marcorispoli/PCB303/LAYOUT/Layout.png

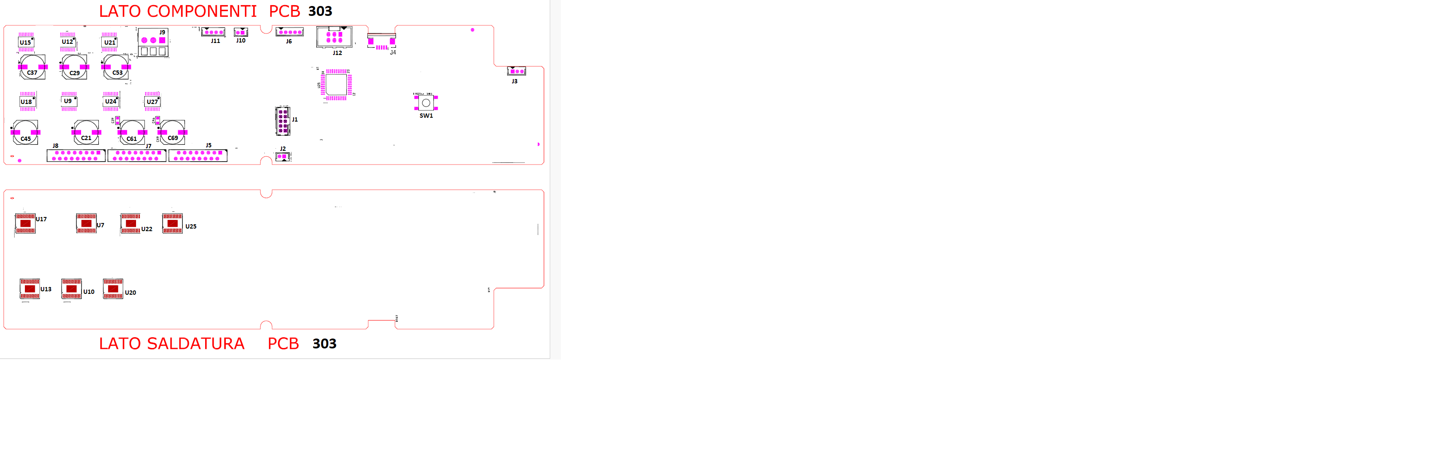
LAYOUT/Layout.png
