marcorispoli/PCB303/(list of files, cad)

Other CAD files:
ESECUTIVI/PF22-303-0.dwg
LAYOUT/22-303-0.dwg
ESECUTIVI/PM22-303-0.dwg
