marcorispoli/PCB303/ORCAD/SE22-303-0.pdf

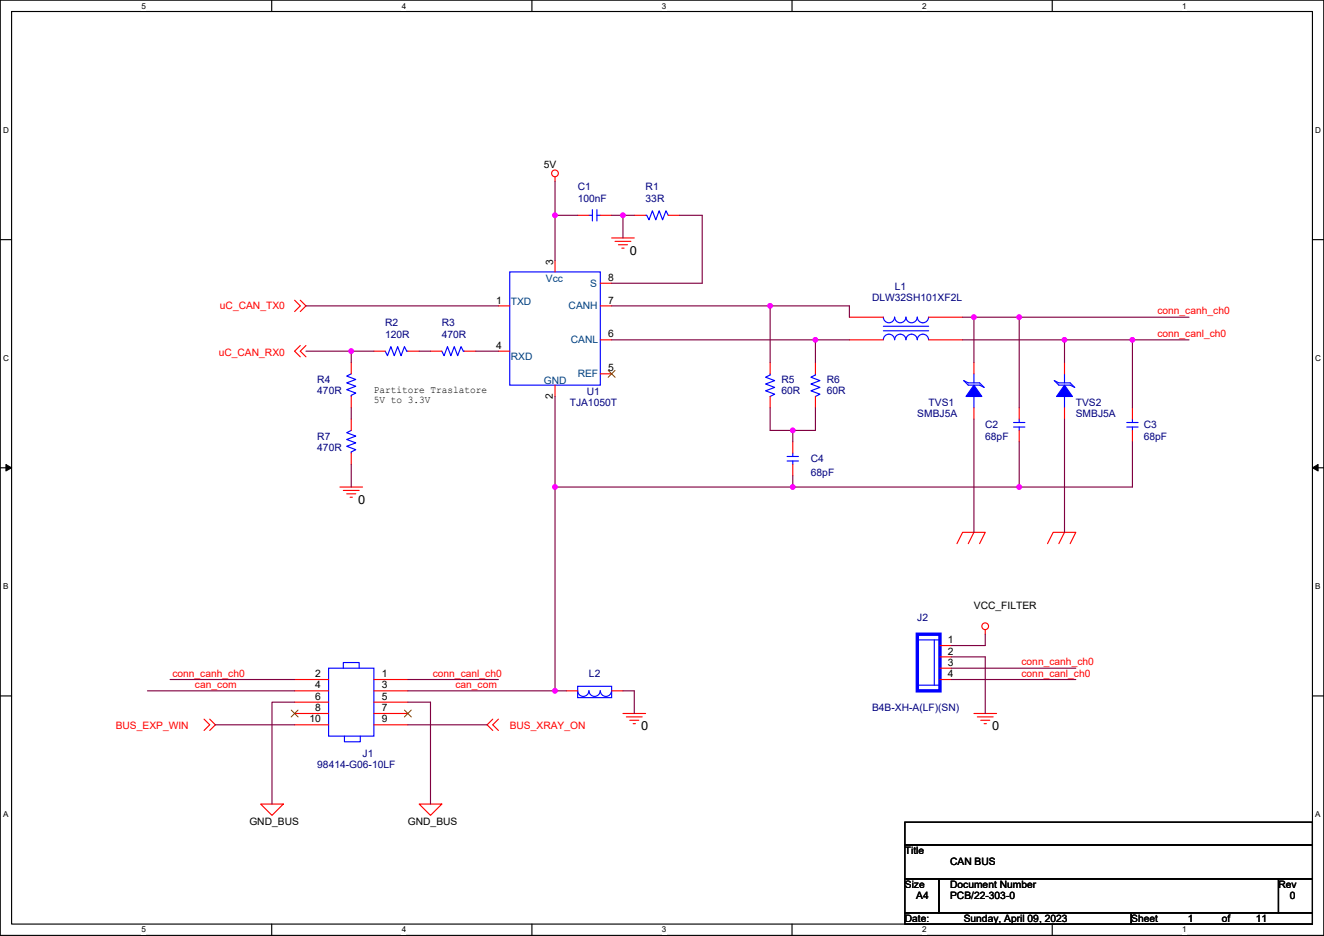
[picture p2: page 1]

Size A4 | Document Number PCB/22-303-0 | Rev 0

Date: Sunday, April 09, 2023 Sunday, April 09, 2023 Sunday, April 09, 2023 | Sheet 1 1 1 of 11 11 11

0

0

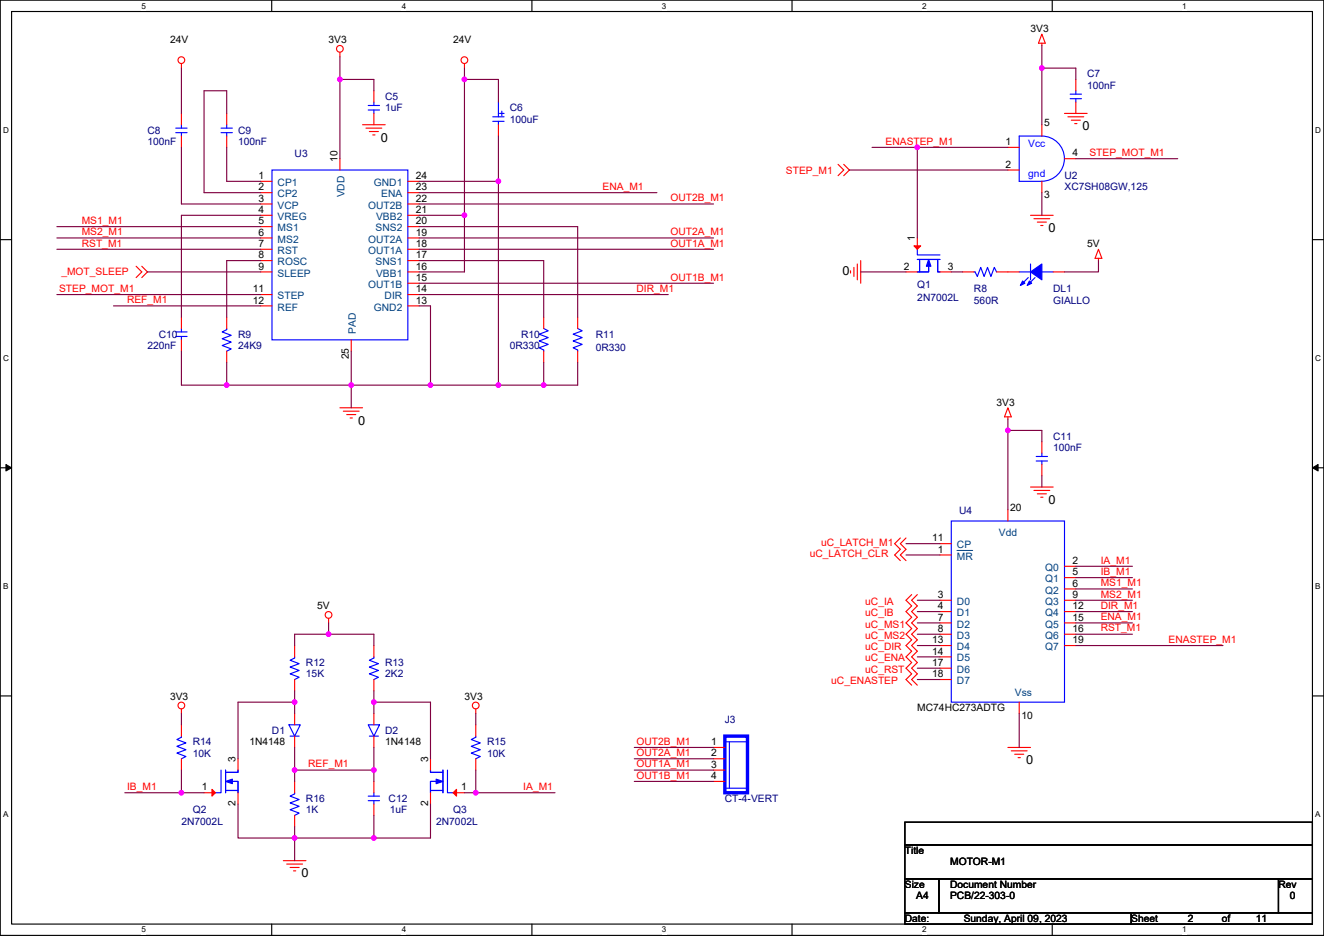
[picture p3: page 2]

0

0

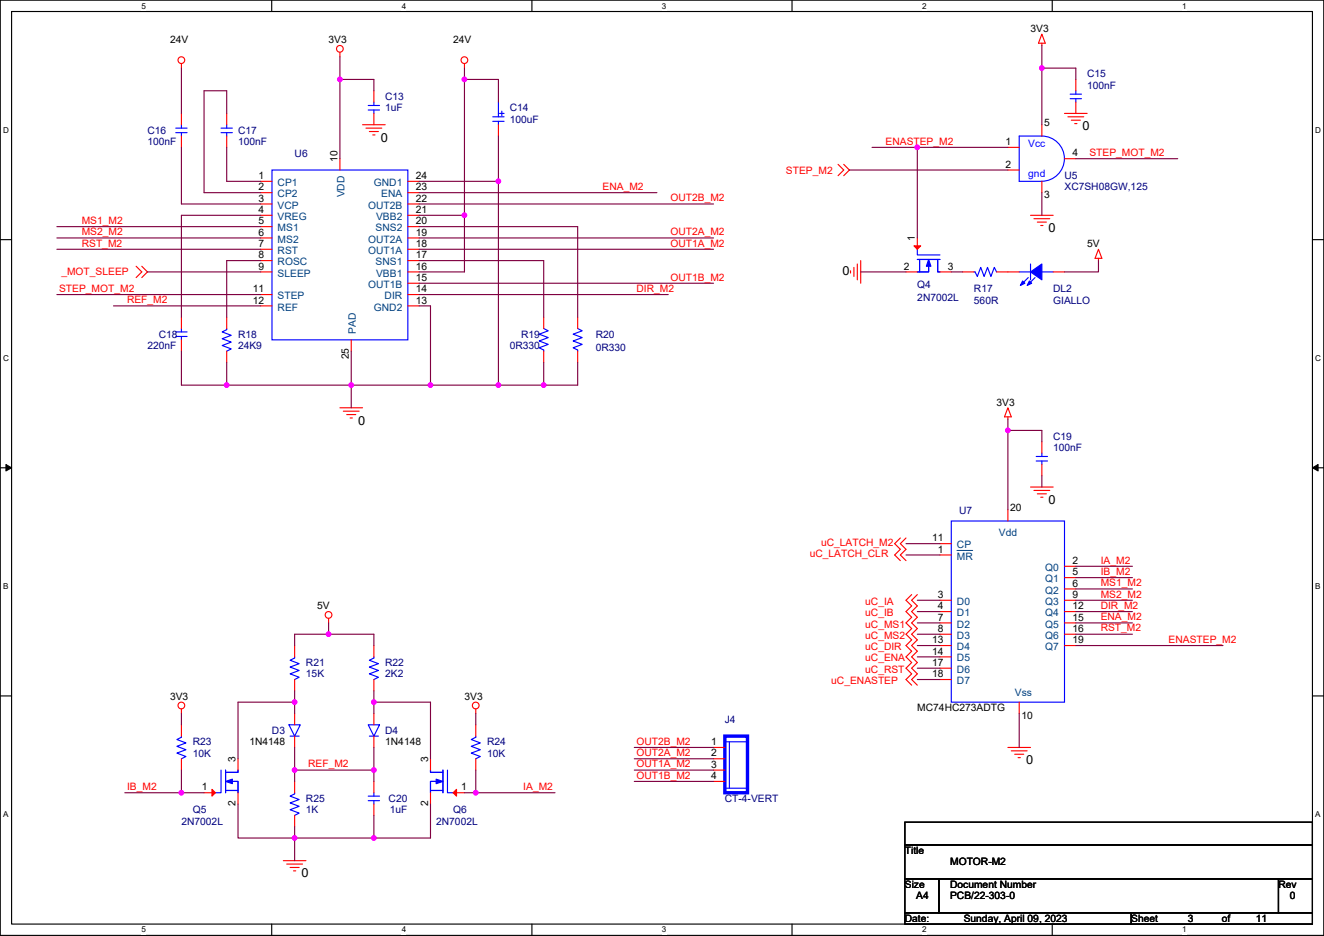
[picture p4: page 3]

0

0

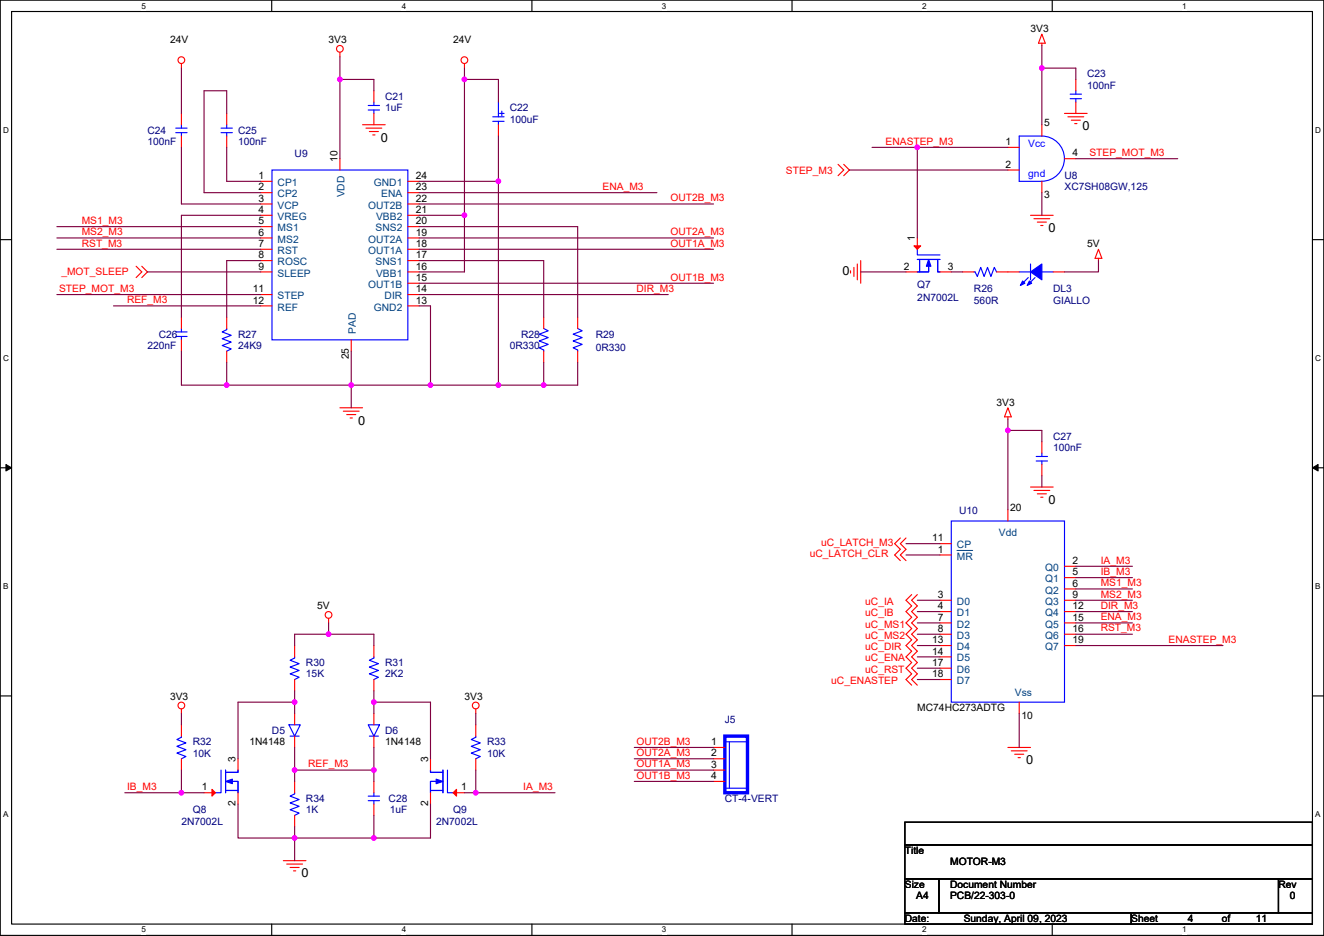
[picture p5: page 4]

0

0

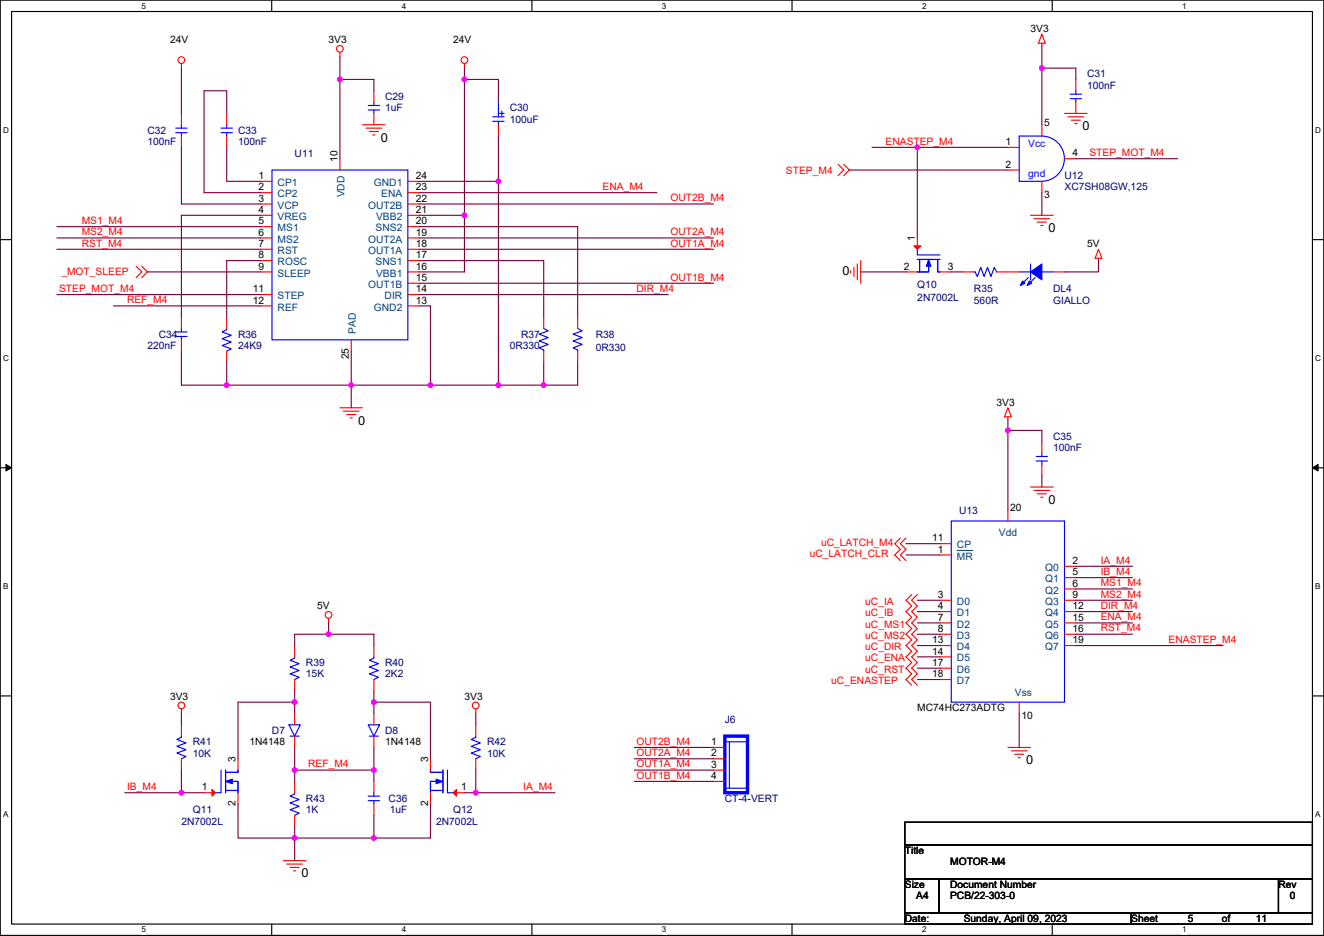
[picture p6: page 5]

0

0

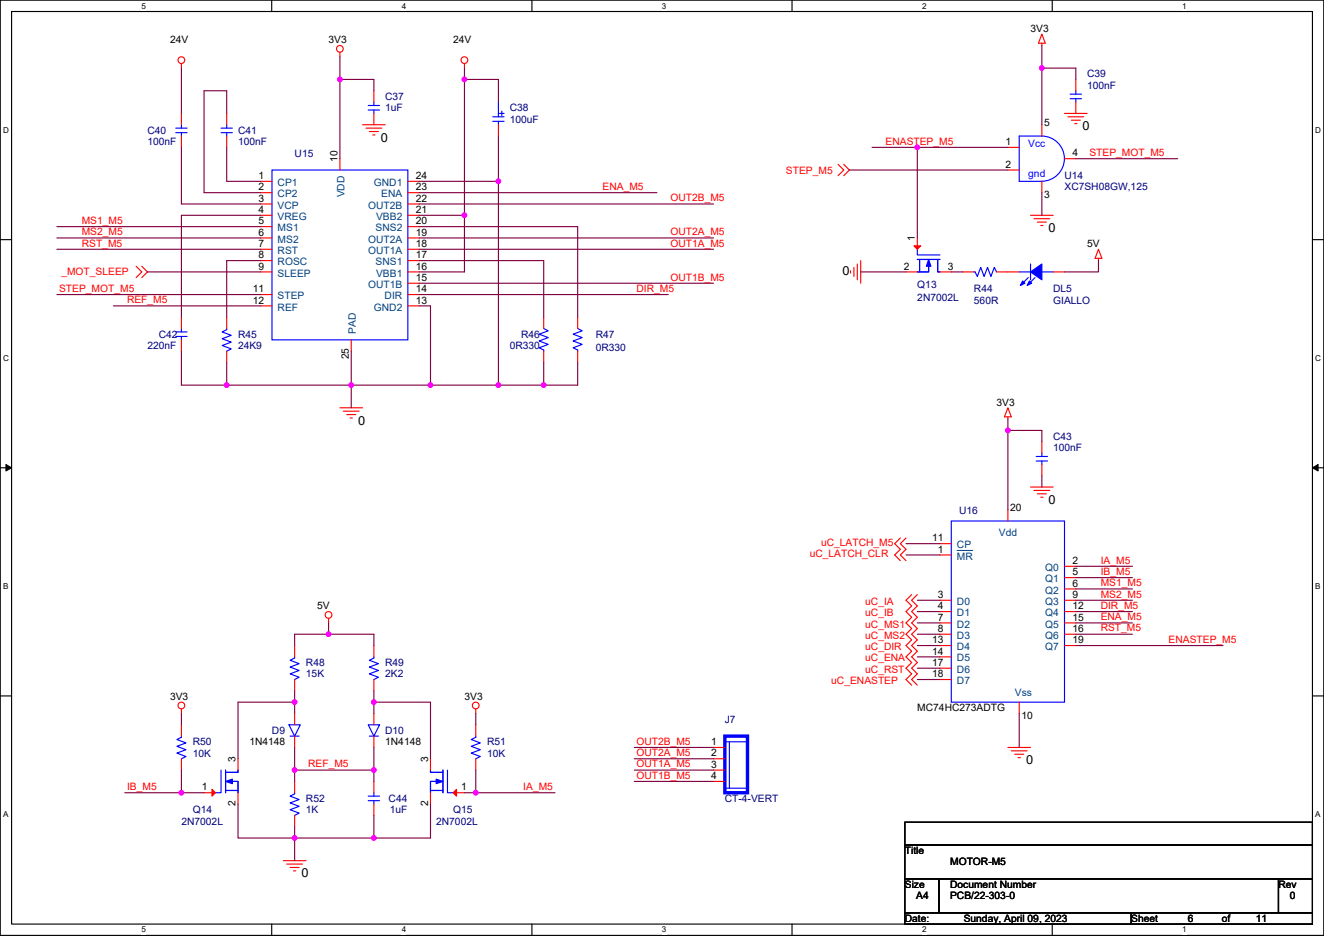
[picture p7: page 6]

0

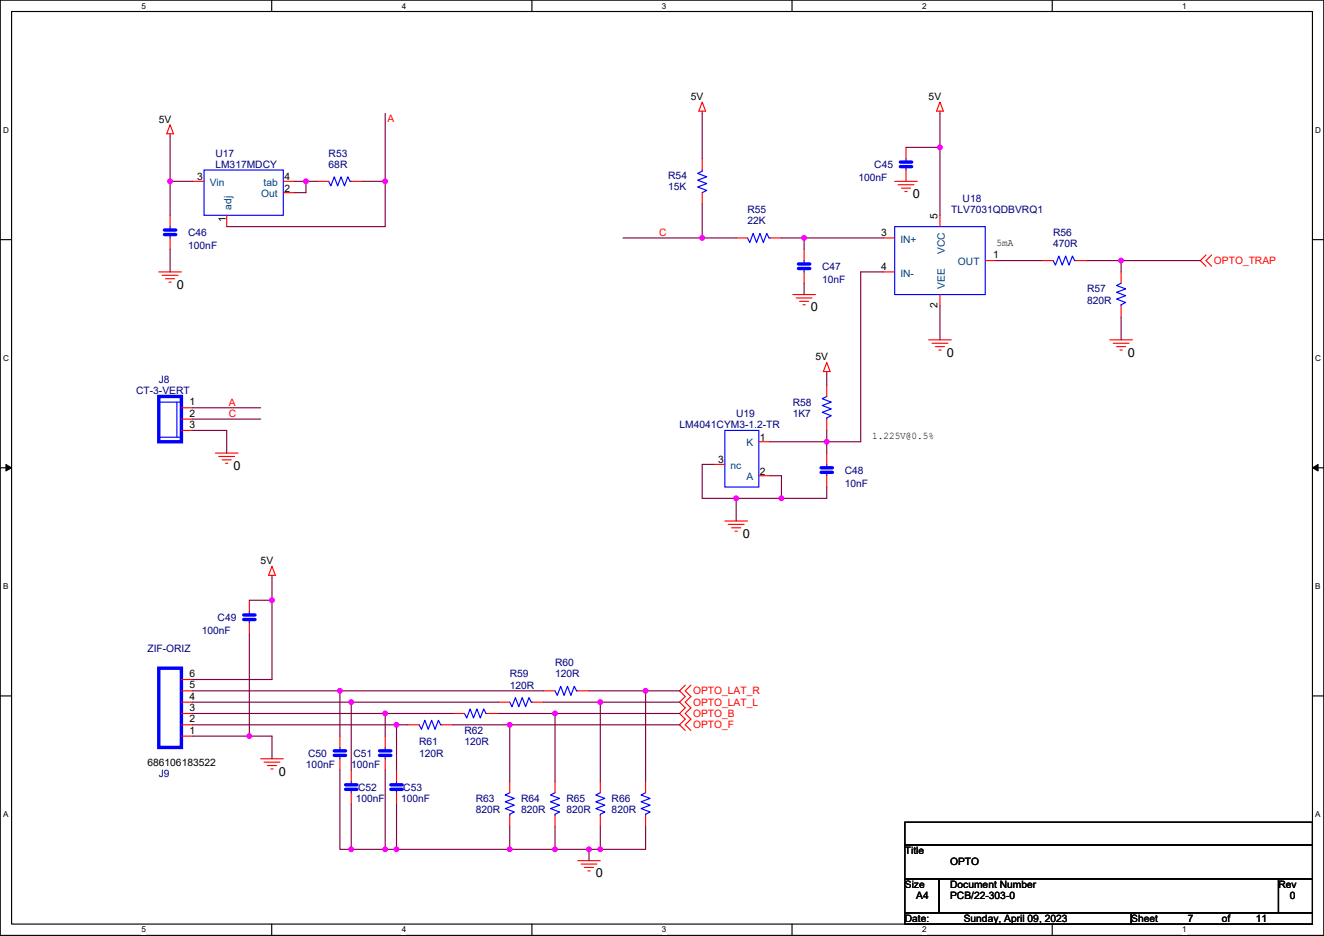
[picture p8: page 7]

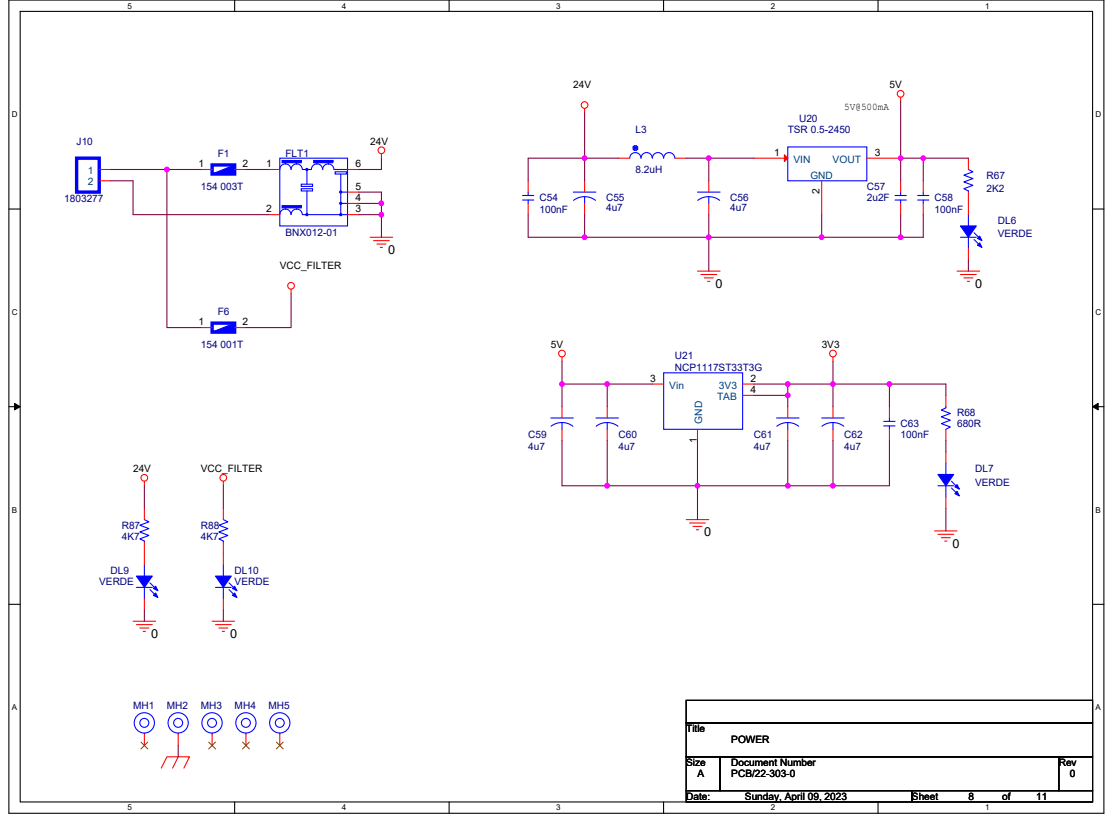
[picture p9: page 8]

Sunday, April 09, 2023 Sunday, April 09, 2023 Sunday, April 09, 2023 | 8 8 8 11 11 11

0

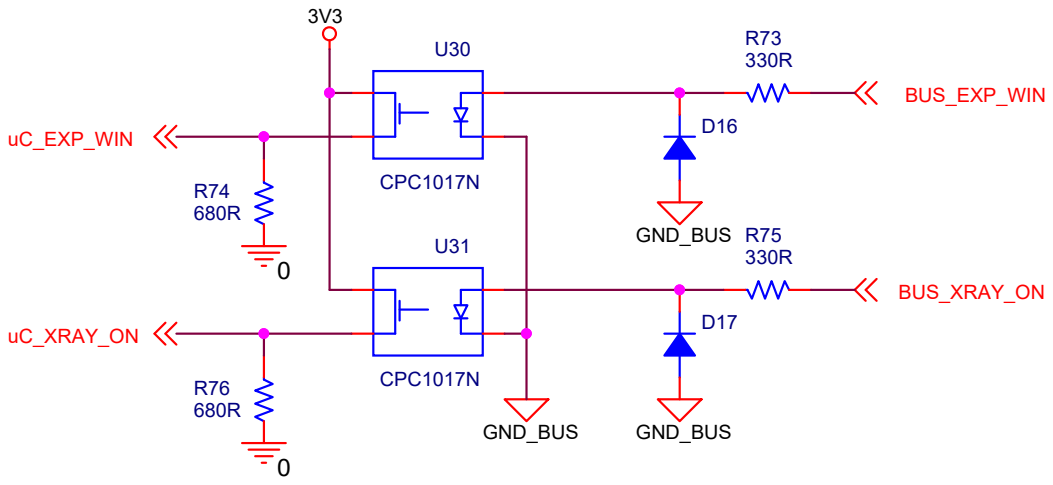
[picture p10: page 9]

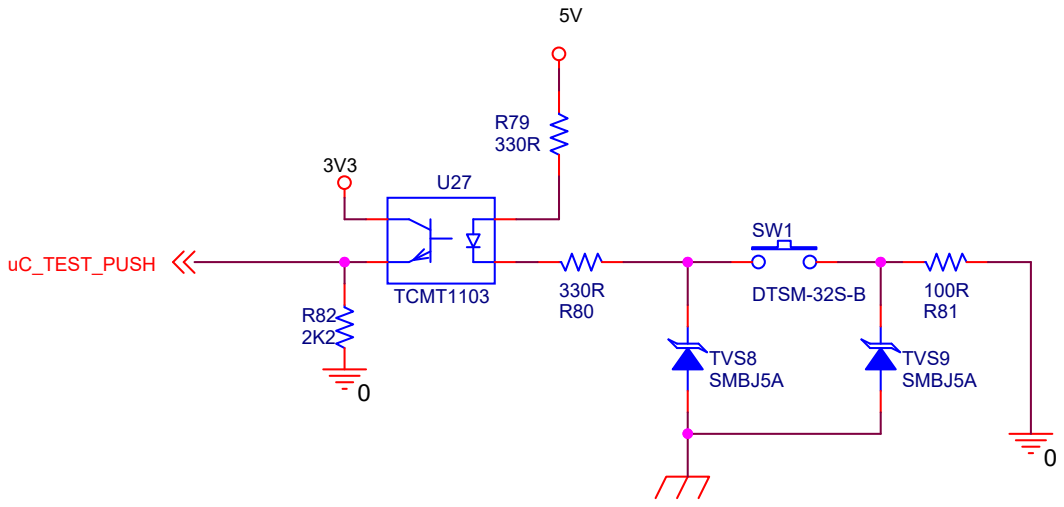
[picture p11: page 10]
uC_TEST_PUSH; Title; TEST BUTTON; TVS9 SMBJ5A; TCMT1103; DTSM-32S-B; TVS8 SMBJ5A

Sunday, April 09, 2023 Sunday, April 09, 2023 Sunday, April 09, 2023 | 10 10 10 11 11 11

0
0

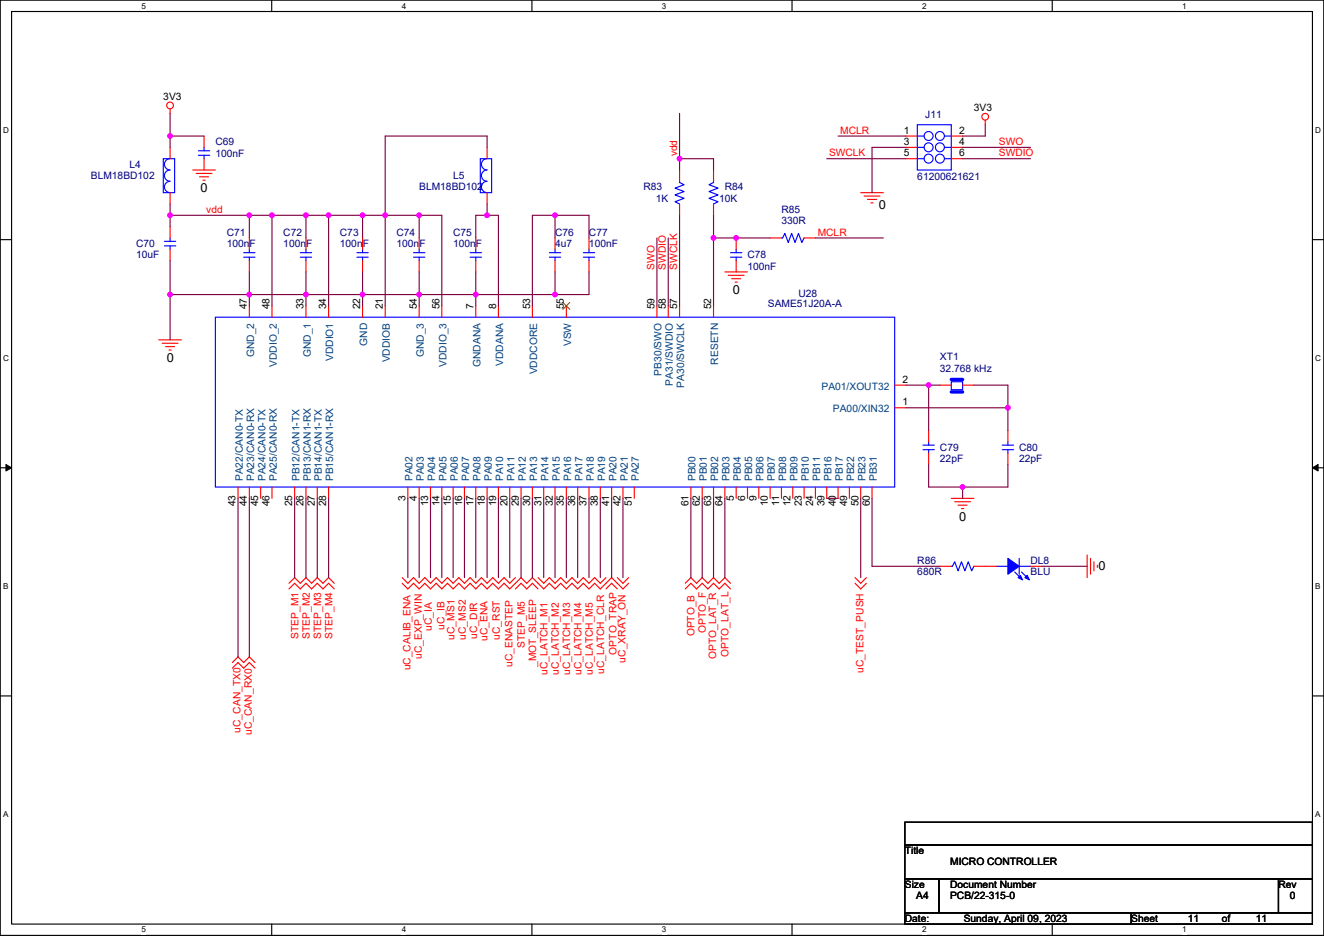
[picture p12: page 11]

PCB/22-315-0 PCB/22-315-0 PCB/22-315-0 | 0 0 0

Sunday, April 09, 2023 Sunday, April 09, 2023 Sunday, April 09, 2023 | 11 11 11
