marcorispoli/PCB303/ESECUTIVI/PF22-303-0.pdf

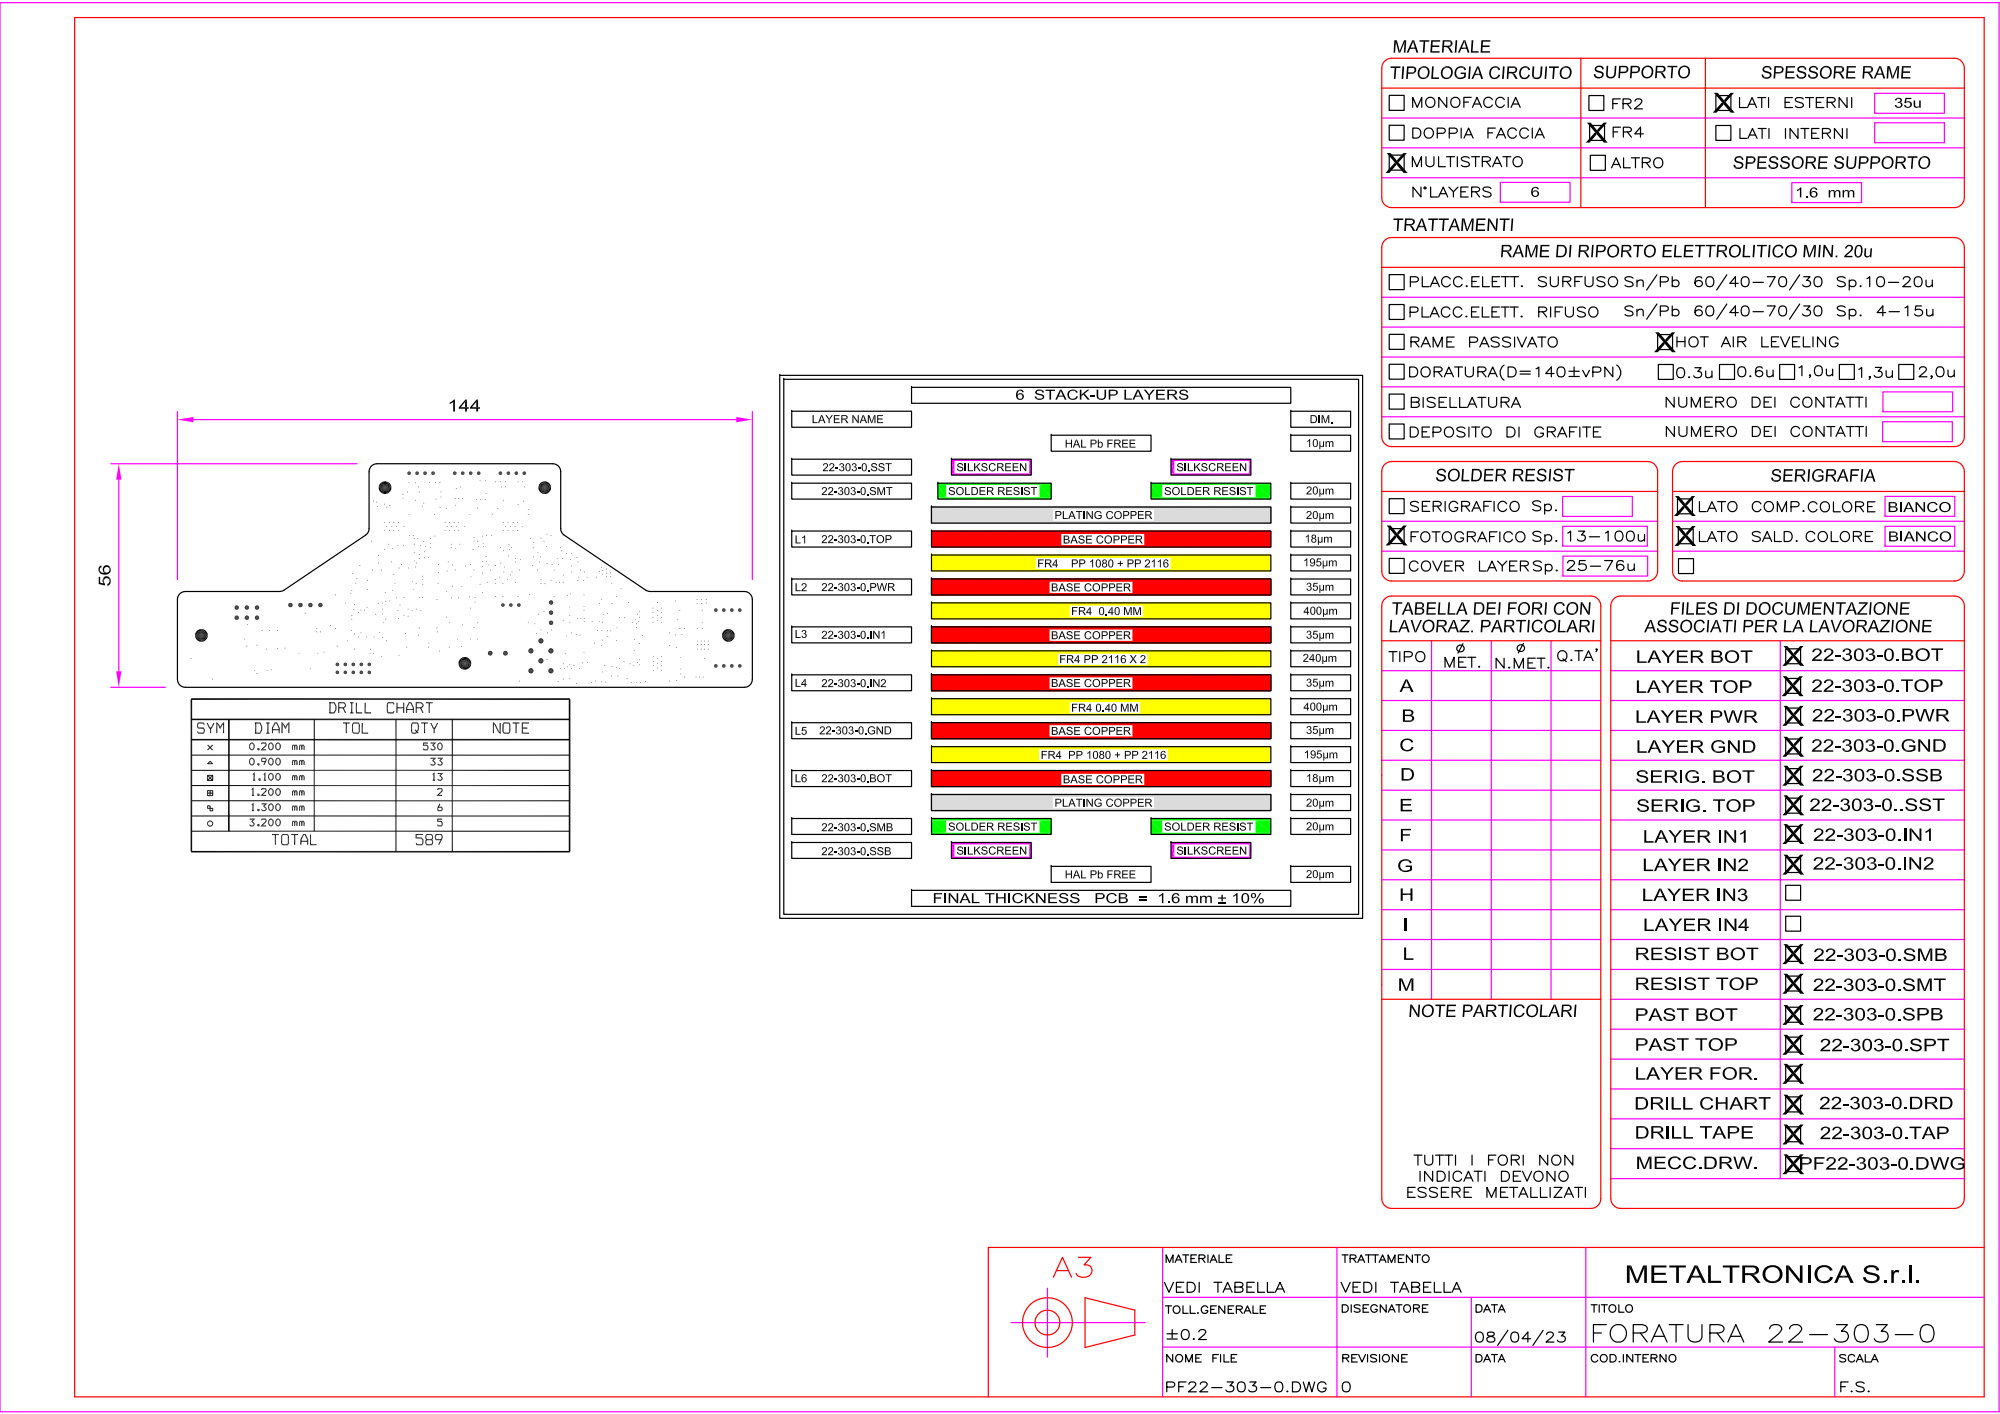
[picture p13: page 1]
