marcorispoli/PCB303/ESECUTIVI/PM22-303-0.pdf

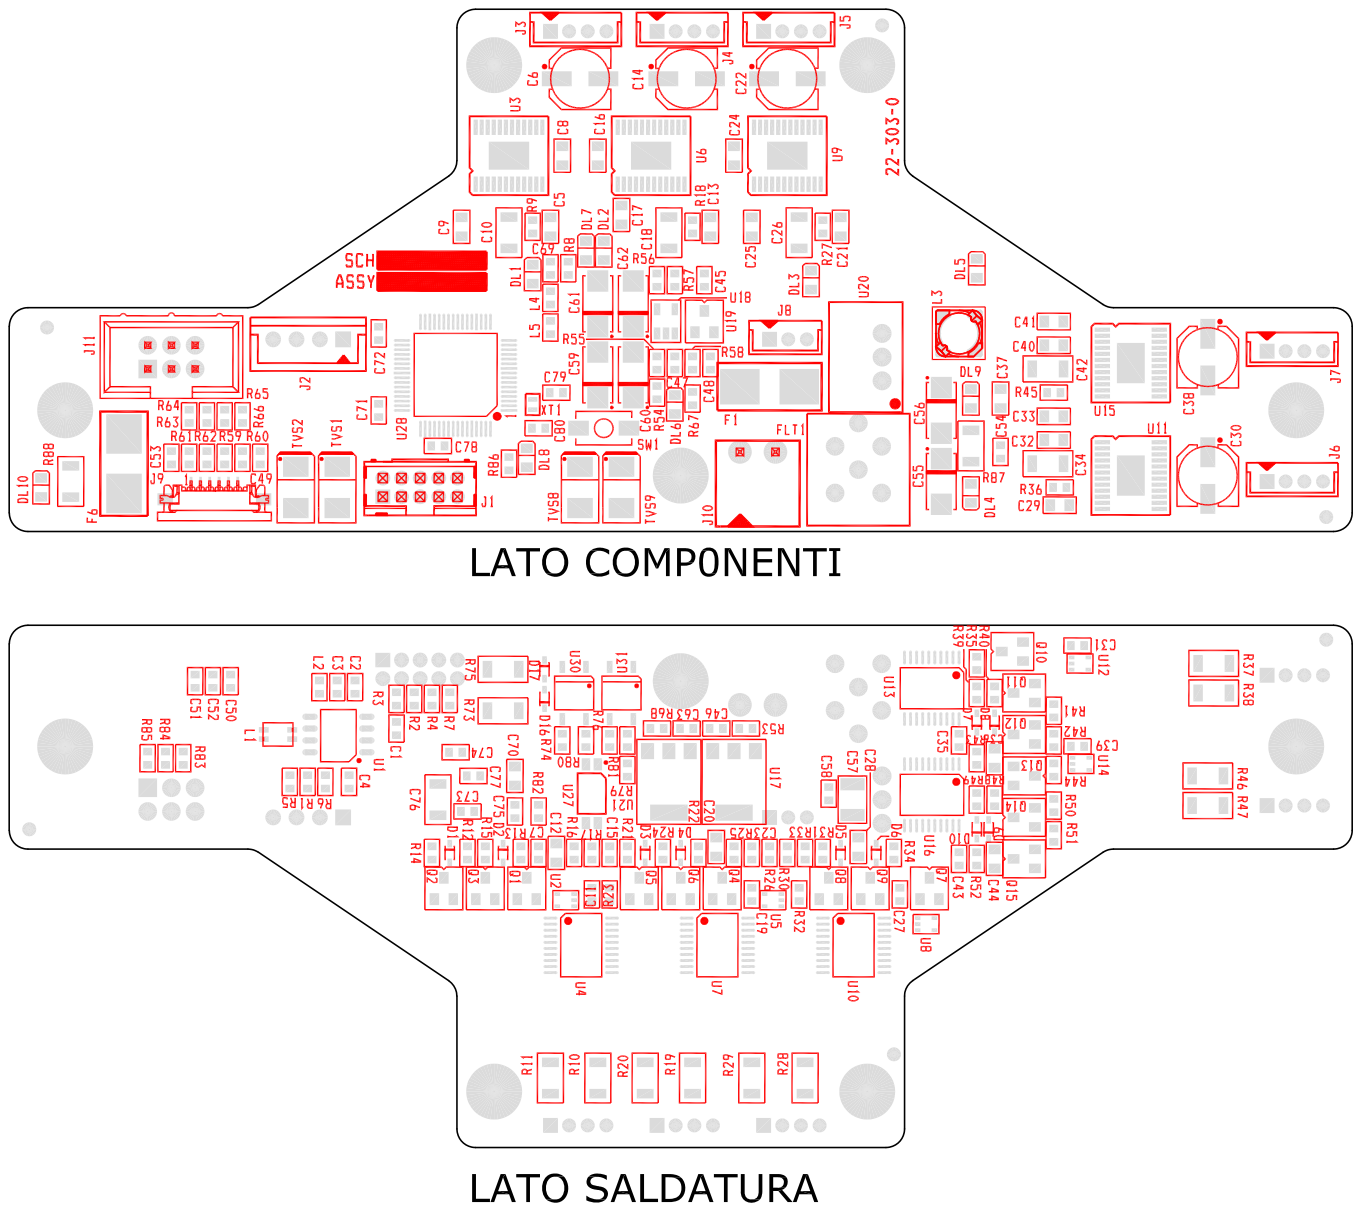
[picture p14: page 1]
