marcorispoli/PCB303/(list of files, drawings)

Other design files:
ORCAD/22-303-0.DSN
ORCAD/22-303-0.opj
