marcorispoli/PCB303/(commit log)

2023-03-06 Primo commit
    [22-303-0.DSN, 22-303-0.opj]
2023-03-07 Quasi completata
    [22-303-0.DSN, 22-303-0.opj]
2023-04-11 Completato sbroglio Osvaldo: richiesta quotazione a Soldà
    [22-303-0.DSN, 22-303-0.dwg, 22-303-0.opj, LP22-303-0.xlsx, PF22-303-0.dwg, PM22-303-0.dwg]
2024-01-30 Modificato C48 da 10nF a 100nF per possibile instabilità Vref
    [22-303-0.DSN, 22-303-0.opj, LP22-303-0.xlsx]
2024-07-09 Completato Schematico e Layout Necessita verifica su limitazione correnti motore e alimentazione
    [22-303-0.DSN, 22-303-0.opj]
2024-09-12 Completato schematico per nuovo collimatore
    [22-303-0.DSN, 22-303-0.opj]
